kaikai581/arduino-thermistor/README.md

# arduino-thermistor
Measuring temperature with an Arduino Uno board and thermistors.
