kaikai581/arduino-thermistor/readout_scripts/adc_to_temperature.png

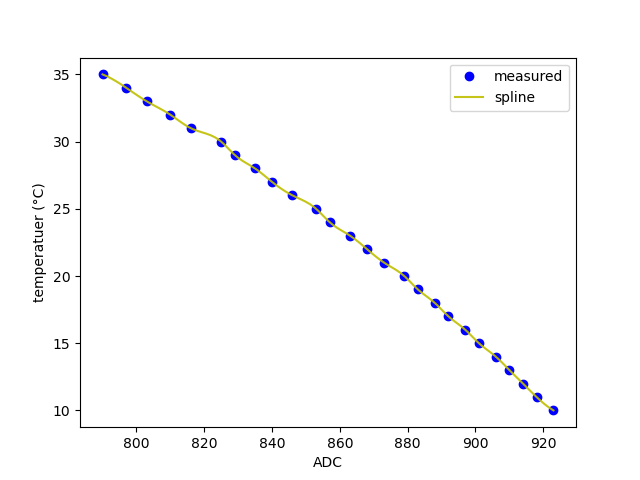
readout_scripts/adc_to_temperature.png
